AarnimM22/HD800-wireless/README.md

view online:
https://kicanvas.org/?repo=https%3A%2F%2Fgithub.com%2FAarnimM22%2FHD800-wireless
