AarnimM22/HD800-wireless/design/HD800-wireless-01 USB Charging.png

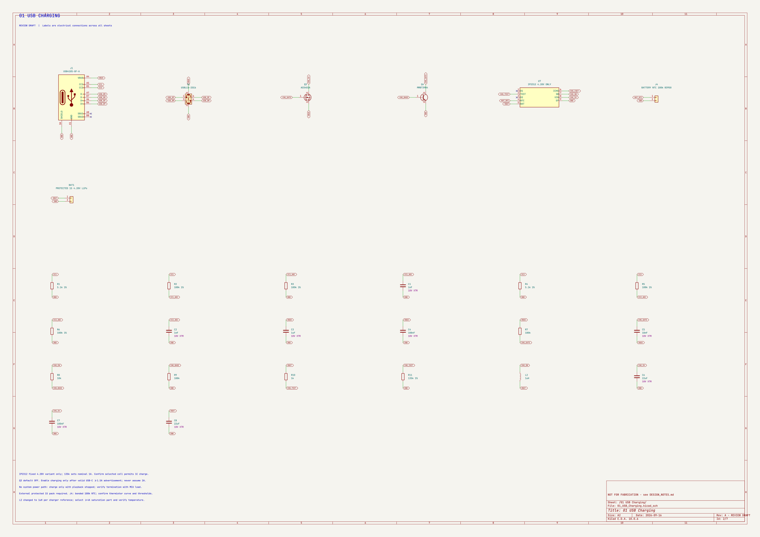
design/HD800-wireless-01 USB Charging.png
