AarnimM22/HD800-wireless/design/HD800-wireless-02 Power.png

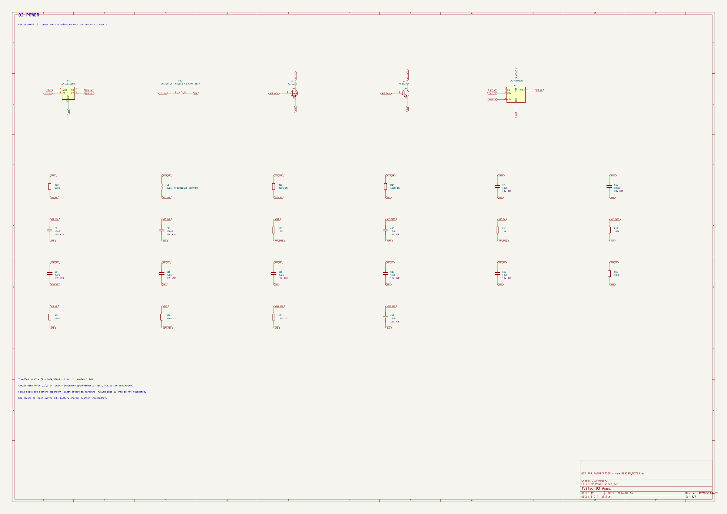
design/HD800-wireless-02 Power.png
