AarnimM22/HD800-wireless/design/HD800-wireless-03 MCU RF.png

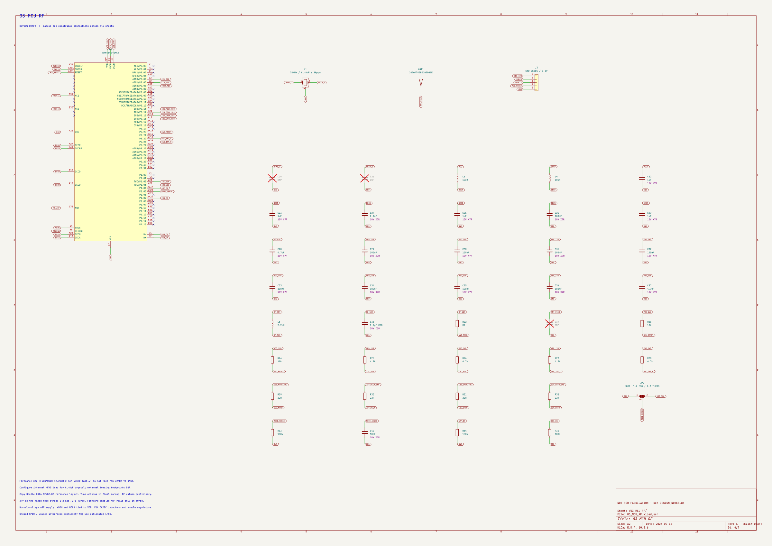
design/HD800-wireless-03 MCU RF.png
