AarnimM22/HD800-wireless/design/HD800-wireless-04 DAC Left.png

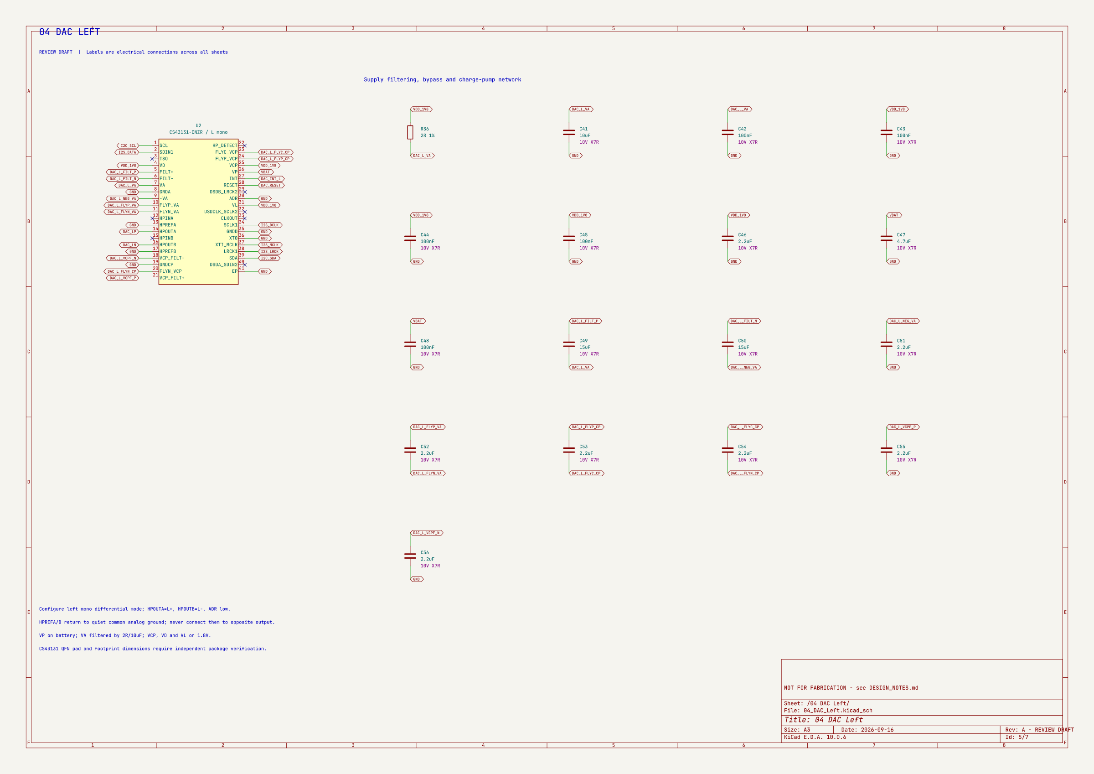
design/HD800-wireless-04 DAC Left.png
