AarnimM22/HD800-wireless/design/HD800-wireless-06 Balanced Output.png

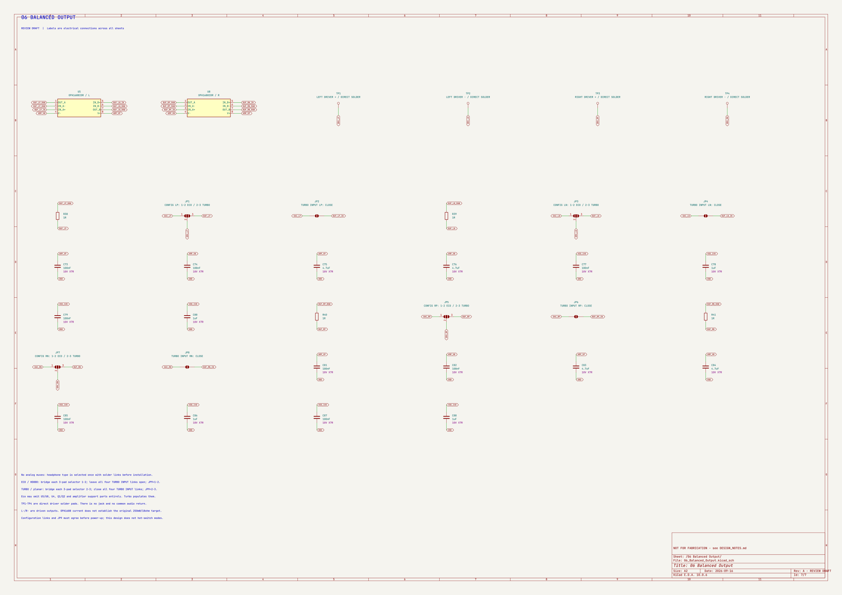
design/HD800-wireless-06 Balanced Output.png
