AarnimM22/HD800-wireless/design/HD800-wireless.png

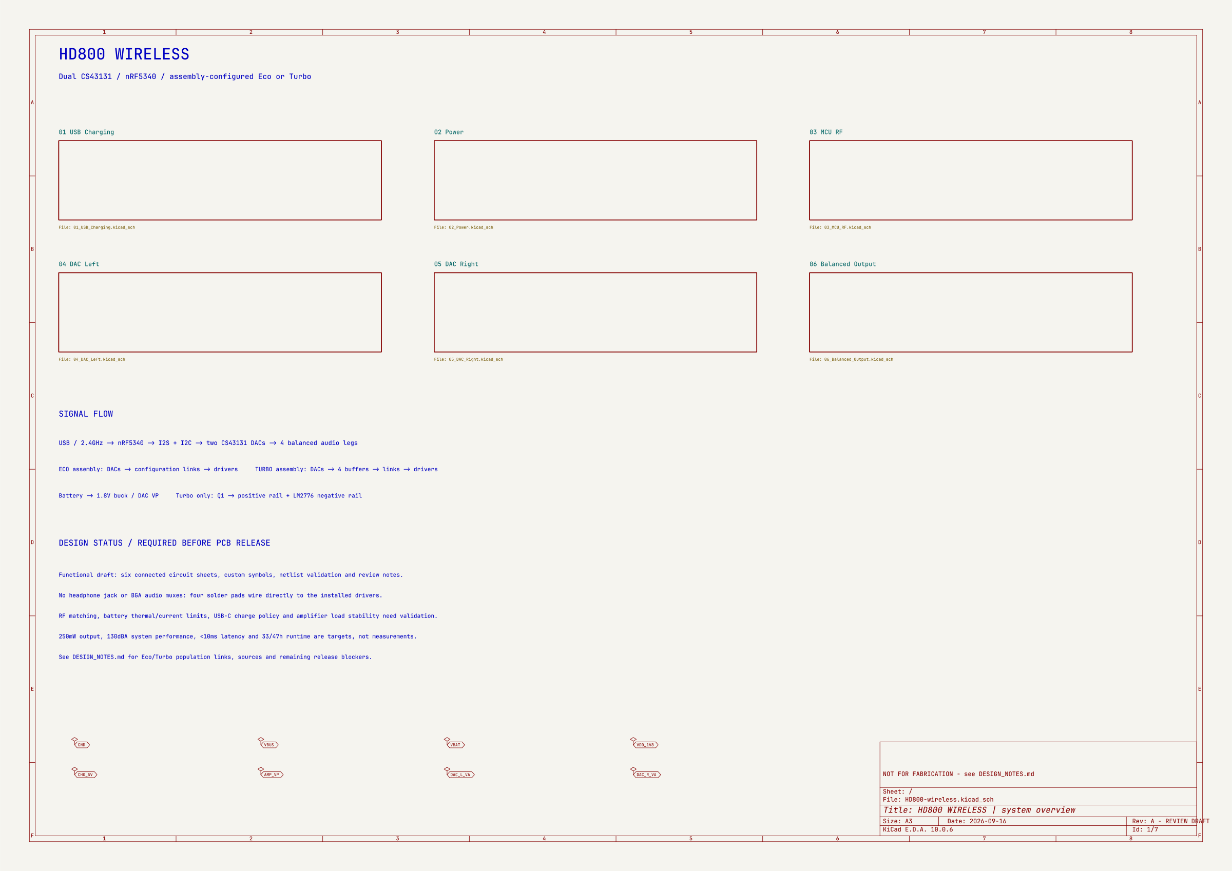
design/HD800-wireless.png
