AarnimM22/HD800-wireless/HD800-wireless.step

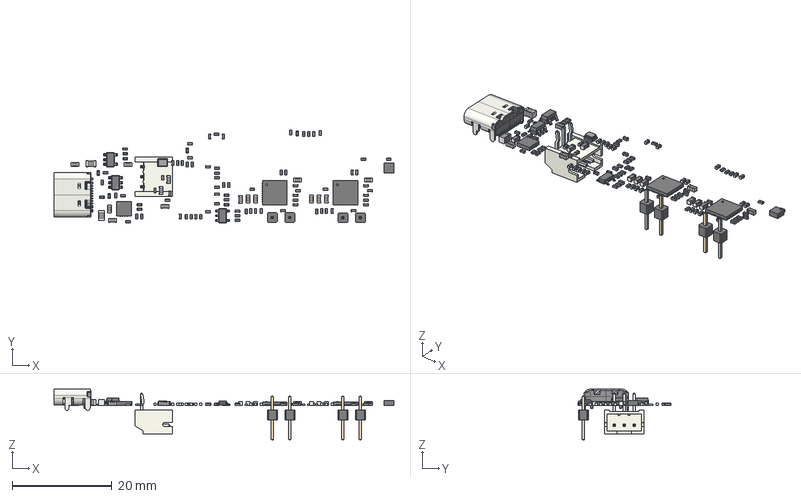
[picture p7: CAD file, 2026-09-24]
HD800-wireless.step
68.3 x 18.7 x 10.2 mm
R_0402_1005Metric x 31
C_0402_1005Metric x 53
USB_C_Receptacle_16P_TopMnt_Horizontal_GCT_USB4105-xx-A
L_0603_1608Metric x 2
C_0603_1608Metric x 13
L_0805_2012Metric x 2
SOT-23-5
Crystal_SMD_2016-4Pin_2.0x1.6mm
QFN-16-1EP_3x3mm_P0.5mm_EP1.7x1.7mm
TSOT-23-5
b3e03259-ada3-11ed-ad3b-6f420da3e38c_part x 2
b3e0325a-ada3-11ed-ad3b-6f420da3e38c_part x 2
b3e0325b-ada3-11ed-ad3b-6f420da3e38c_part x 2
L_0402_1005Metric
LGA_12_2x2mm_P05mm
SOT-23-6
PinHeader_1x01_P200mm_Vertical x 4
JST_S3B_PH_K
