AarnimM22/HD800-wireless/HD800-wireless.kicad_pcb

## KiCad design HD800-wireless.kicad_pcb (2026-09-24)

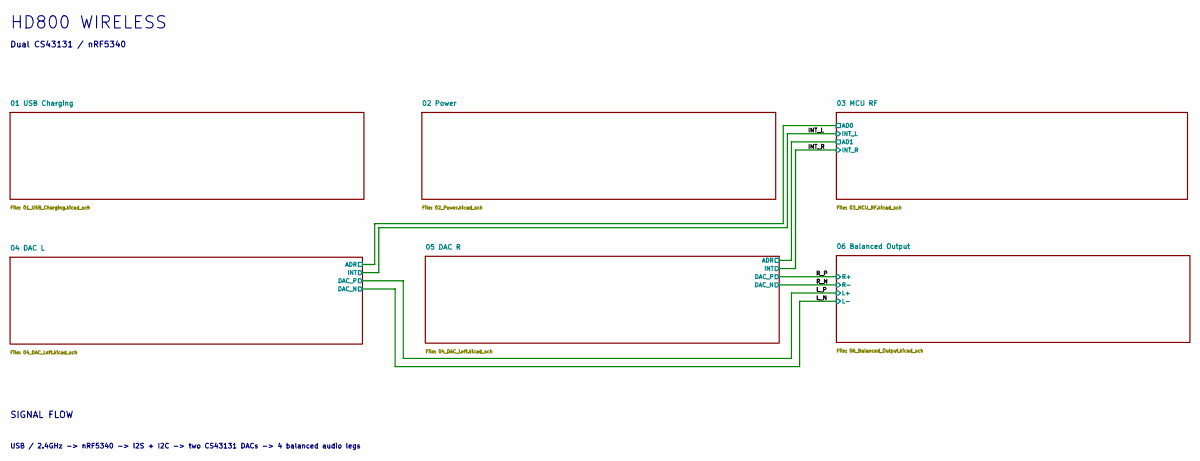
[picture p8: schematic HD800-wireless.kicad_sch, HD800 WIRELESS | system overview]

Notes on the sheet:
USB / 2.4GHz -> nRF5340 -> I2S + I2C -> two CS43131 DACs -> 4 balanced audio legs
Dual CS43131 / nRF5340
HD800 WIRELESS
SIGNAL FLOW

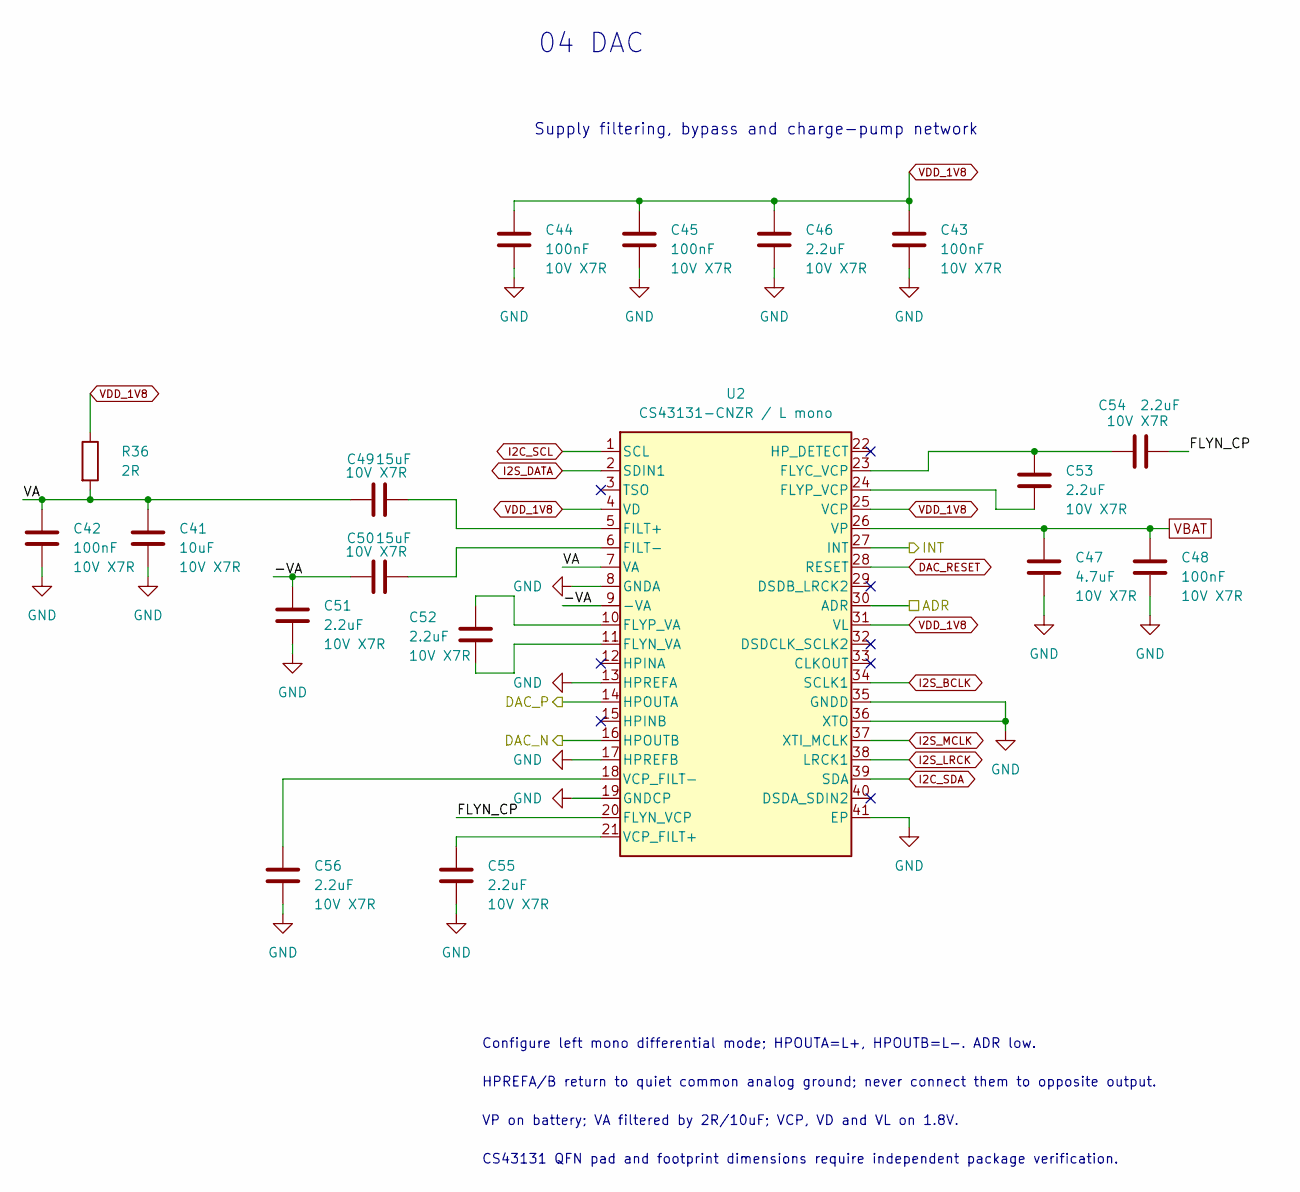
[picture p9: schematic 04_DAC_Left.kicad_sch, 04 DAC Left]

Parts:
C41: 10uF; C_0603_1608Metric; Voltage 10V X7R
C42, C43, C44, C45, C48: 100nF; C_0402_1005Metric; Voltage 10V X7R
C46, C51, C52, C53, C54, C55, C56: 2.2uF; C_0402_1005Metric; Voltage 10V X7R
C47: 4.7uF; C_0603_1608Metric; Voltage 10V X7R
C49, C50: 15uF; C_0603_1608Metric; Voltage 10V X7R
R36: 2R; R_0402_1005Metric
U2: CS43131-CNZR / L mono; TQFN-40-1EP_5x5mm_P0.4mm_EP3.5x3.5mm_ThermalVias

Connections:
/04 DAC L/-VA: C50.1, C51.1, U2.9 (-VA)
/04 DAC L/FLYN_CP: C54.2, U2.20 (FLYN_VCP)
/04 DAC L/VA: C41.1, C42.1, C49.1, R36.2, U2.7 (VA)
/INT_L: U2.27 (INT); also elsewhere on the board
/L_N: U2.16 (HPOUTB); also elsewhere on the board
/L_P: U2.14 (HPOUTA); also elsewhere on the board
DAC_RESET: U2.28 (RESET); also elsewhere on the board
GND: C41.2, C42.2, C43.2, C44.2, C45.2, C46.2, C47.2, C48.2, C51.2, C55.2, C56.2, U2.8 (GNDA), U2.13 (HPREFA), U2.17 (HPREFB), U2.19 (GNDCP), U2.30 (ADR), U2.35 (GNDD), U2.36 (XTO), U2.41 (EP); also elsewhere on the board
I2C_SCL: U2.1 (SCL); also elsewhere on the board
I2C_SDA: U2.39 (SDA); also elsewhere on the board
I2S_BCLK: U2.34 (SCLK1); also elsewhere on the board
I2S_DATA: U2.2 (SDIN1); also elsewhere on the board
I2S_LRCK: U2.38 (LRCK1); also elsewhere on the board
I2S_MCLK: U2.37 (XTI_MCLK); also elsewhere on the board
unnamed: C49.2, U2.5 (FILT+)
unnamed: C50.2, U2.6 (FILT-)
unnamed: C53.1, C54.1, U2.23 (FLYC_VCP)
unnamed: C52.2, U2.11 (FLYN_VA)
unnamed: C52.1, U2.10 (FLYP_VA)
unnamed: C53.2, U2.24 (FLYP_VCP)
unnamed: C55.1, U2.21 (VCP_FILT+)
unnamed: C56.1, U2.18 (VCP_FILT-)
VBAT: C47.1, C48.1, U2.26 (VP); also elsewhere on the board
VDD_1V8: C43.1, C44.1, C45.1, C46.1, R36.1, U2.4 (VD), U2.25 (VCP), U2.31 (VL); also elsewhere on the board

Parts of its further copies:
C57, C65, C66, C68, C72: 100nF; C_0402_1005Metric; Voltage 10V X7R
C58: 10uF; C_0603_1608Metric; Voltage 10V X7R
C59, C60, C63, C64, C67, C69, C71: 2.2uF; C_0402_1005Metric; Voltage 10V X7R
C61, C62: 15uF; C_0603_1608Metric; Voltage 10V X7R
C70: 4.7uF; C_0603_1608Metric; Voltage 10V X7R
R37: 2R; R_0402_1005Metric
U3: CS43131-CNZR / L mono; TQFN-40-1EP_5x5mm_P0.4mm_EP3.5x3.5mm_ThermalVias

Connections of its further copies:
/05 DAC R/-VA: C60.1, C62.1, U3.9 (-VA)
/05 DAC R/FLYN_CP: C71.2, U3.20 (FLYN_VCP)
/05 DAC R/VA: C57.1, C58.1, C61.1, R37.2, U3.7 (VA)
/INT_R: U3.27 (INT); also elsewhere on the board
/R_N: U3.16 (HPOUTB); also elsewhere on the board
/R_P: U3.14 (HPOUTA); also elsewhere on the board
DAC_RESET: U3.28 (RESET); also elsewhere on the board
GND: C57.2, C58.2, C59.2, C60.2, C63.2, C65.2, C66.2, C67.2, C68.2, C70.2, C72.2, U3.8 (GNDA), U3.13 (HPREFA), U3.17 (HPREFB), U3.19 (GNDCP), U3.35 (GNDD), U3.36 (XTO), U3.41 (EP); also elsewhere on the board
I2C_SCL: U3.1 (SCL); also elsewhere on the board
I2C_SDA: U3.39 (SDA); also elsewhere on the board
I2S_BCLK: U3.34 (SCLK1); also elsewhere on the board
I2S_DATA: U3.2 (SDIN1); also elsewhere on the board
I2S_LRCK: U3.38 (LRCK1); also elsewhere on the board
I2S_MCLK: U3.37 (XTI_MCLK); also elsewhere on the board
unnamed: C61.2, U3.5 (FILT+)
unnamed: C62.2, U3.6 (FILT-)
unnamed: C69.1, C71.1, U3.23 (FLYC_VCP)
unnamed: C64.2, U3.11 (FLYN_VA)
unnamed: C64.1, U3.10 (FLYP_VA)
unnamed: C69.2, U3.24 (FLYP_VCP)
unnamed: C63.1, U3.21 (VCP_FILT+)
unnamed: C59.1, U3.18 (VCP_FILT-)
VBAT: C70.1, C72.1, U3.26 (VP); also elsewhere on the board
VDD_1V8: C65.1, C66.1, C67.1, C68.1, R37.1, U3.4 (VD), U3.25 (VCP), U3.30 (ADR), U3.31 (VL); also elsewhere on the board

Notes on the sheet:
HPREFA/B return to quiet common analog ground; never connect them to opposite output.
Supply filtering, bypass and charge-pump network
Configure left mono differential mode; HPOUTA=L+, HPOUTB=L-. ADR low.
CS43131 QFN pad and footprint dimensions require independent package verification.
04 DAC
VP on battery; VA filtered by 2R/10uF; VCP, VD and VL on 1.8V.

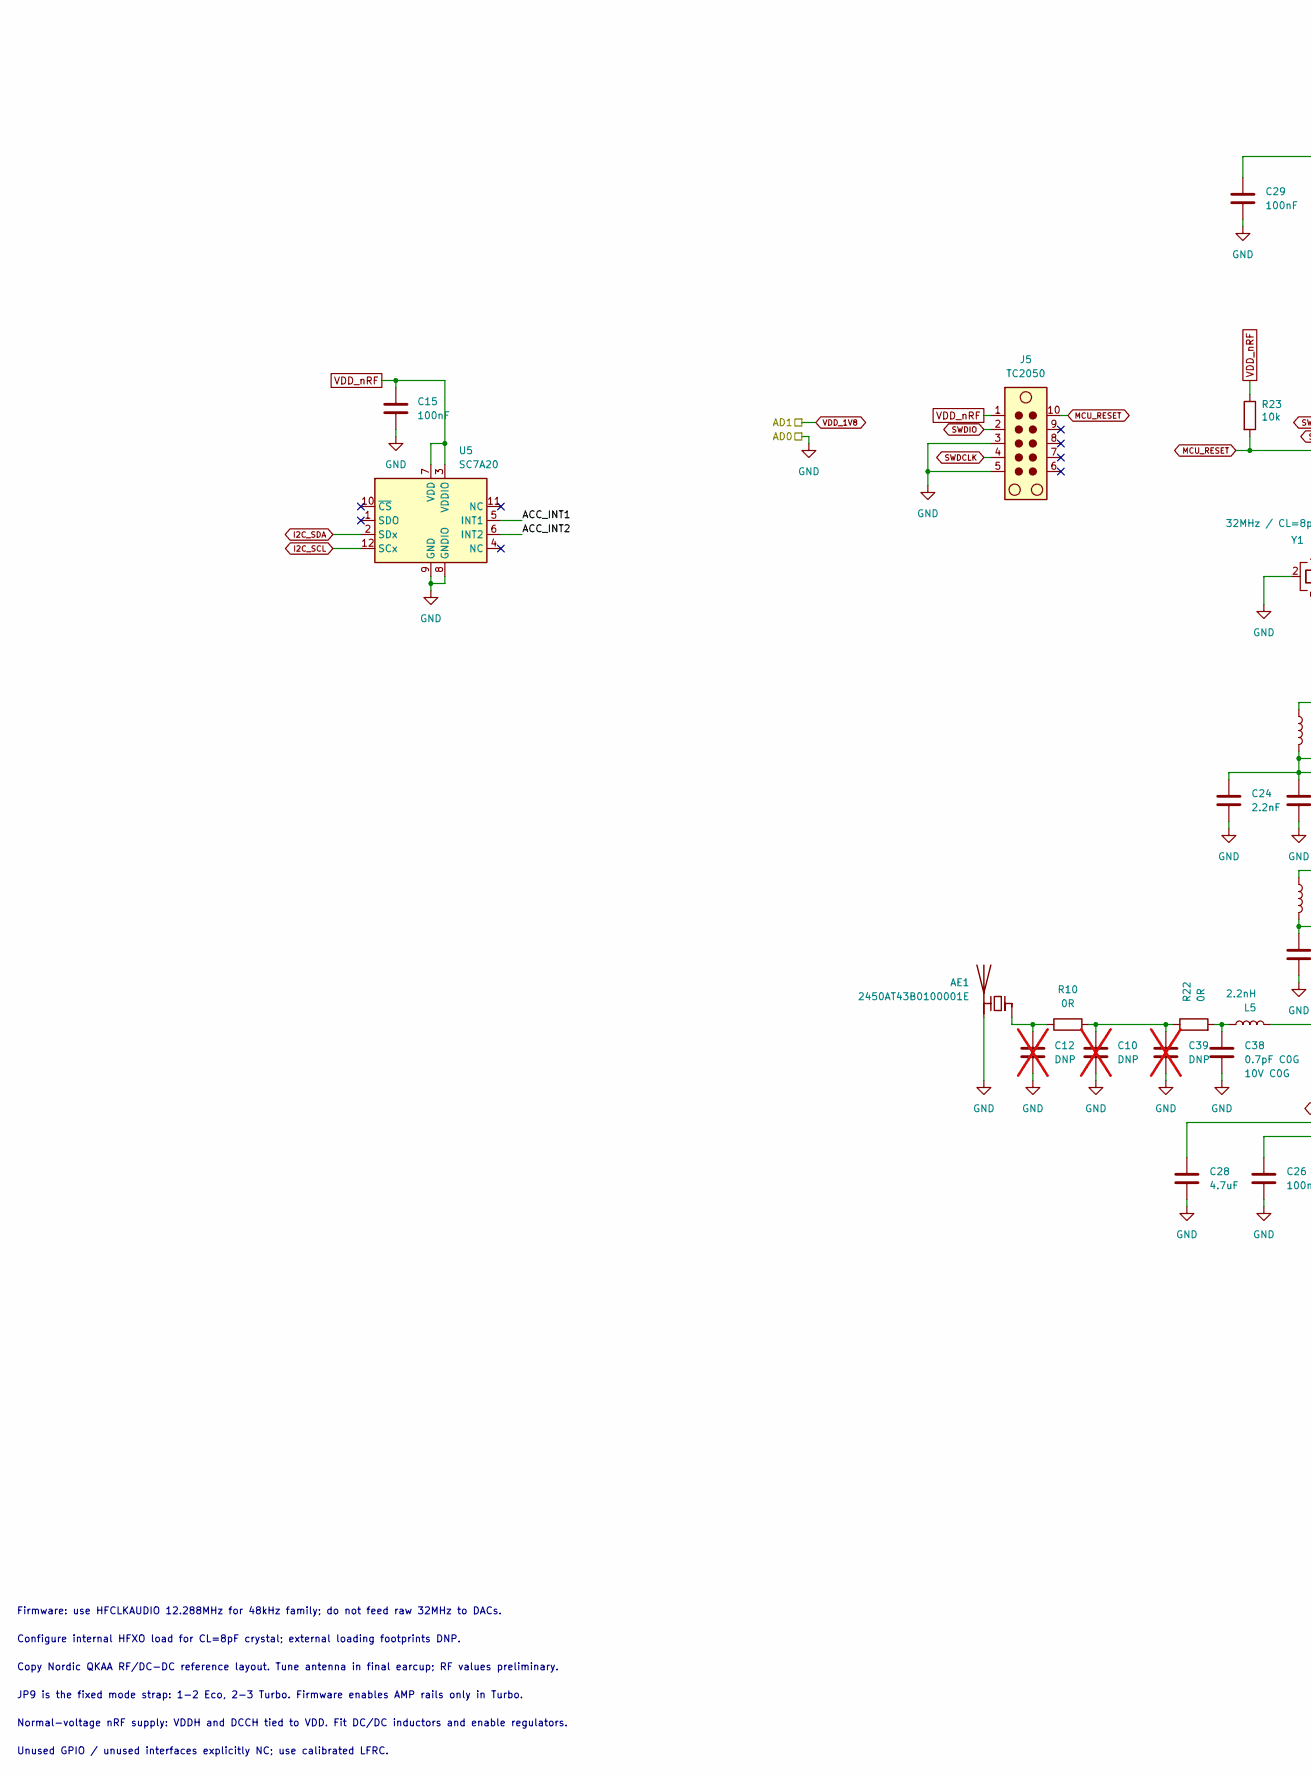
[picture p10: schematic 03_MCU_RF.kicad_sch, 03 MCU RF, part in row 1, column 1]

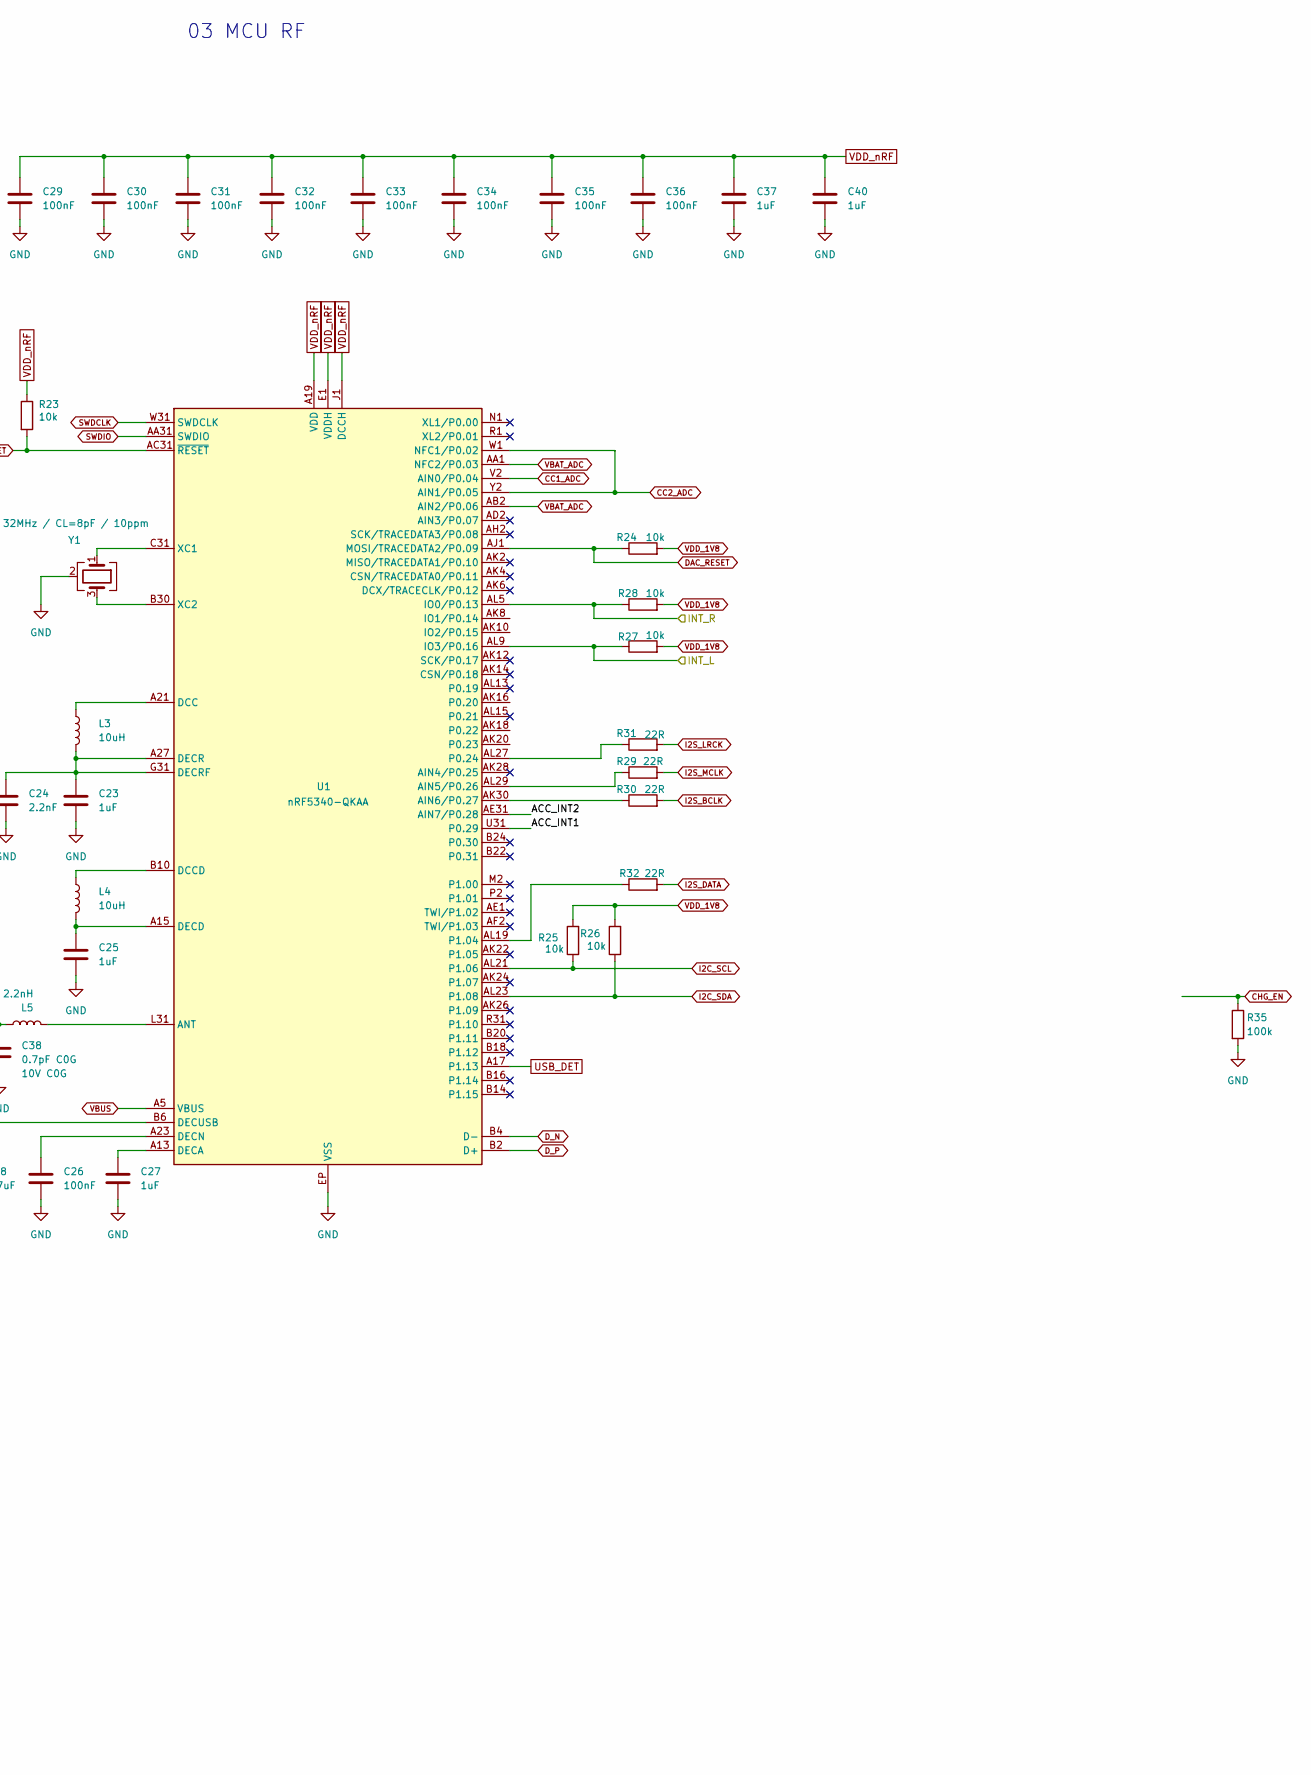
[picture p11: schematic 03_MCU_RF.kicad_sch, 03 MCU RF, part in row 1, column 2]

Parts:
AE1: 2450AT43B0100001E; 2450AT18D0100
C10, C12, C39: DNP; C_0402_1005Metric; not fitted
C15, C26, C29, C30, C31, C32, C33, C34, C35, C36: 100nF; C_0402_1005Metric
C23, C25, C27, C37, C40: 1uF; C_0402_1005Metric
C24: 2.2nF; C_0402_1005Metric
C28: 4.7uF; C_0603_1608Metric
C38: 0.7pF C0G; C_0402_1005Metric; Voltage 10V C0G
J5: TC2050; Tag-Connect_TC2050-IDC-FP_2x05_P1.27mm_Vertical
L3, L4: 10uH; L_0603_1608Metric
L5: 2.2nH; L_0402_1005Metric
R10, R22: 0R; R_0402_1005Metric
R23, R24, R25, R26, R27, R28: 10k; R_0402_1005Metric
R29, R30, R31, R32: 22R; R_0402_1005Metric
R35: 100k; R_0402_1005Metric
U1: nRF5340-QKAA; Nordic_AQFN-94-1EP_7x7mm_P0.4mm
U5: SC7A20; LGA-12_2x2mm_P0.5mm
Y1: 32MHz / CL=8pF / 10ppm; Crystal_SMD_2016-4Pin_2.0x1.6mm

Connections:
/03 MCU RF/ACC_INT1: U1.U31 (P0.29), U5.5 (INT1)
/03 MCU RF/ACC_INT2: U1.AE31 (AIN7/P0.28), U5.6 (INT2)
/INT_L: R27.1, U1.AL9 (IO3/P0.16); also elsewhere on the board
/INT_R: R28.1, U1.AL5 (IO0/P0.13); also elsewhere on the board
CC1_ADC: U1.V2 (AIN0/P0.04); also elsewhere on the board
CC2_ADC: U1.W1 (NFC1/P0.02), U1.Y2 (AIN1/P0.05); also elsewhere on the board
CHG_EN: R35.1; also elsewhere on the board
DAC_RESET: R24.1, U1.AJ1 (MOSI/TRACEDATA2/P0.09); also elsewhere on the board
D_N: U1.B4 (D-); also elsewhere on the board
D_P: U1.B2 (D+); also elsewhere on the board
GND: AE1.2 (PCB_Trace), C10.2, C12.2, C15.2, C23.2, C24.2, C25.2, C26.2, C27.2, C28.2, C29.2, C30.2, C31.2, C32.2, C33.2, C34.2, C35.2, C36.2, C37.2, C38.2, C39.2, C40.2, J5.3, J5.5, R35.2, U1.EP (VSS), U5.8 (GNDIO), U5.9 (GND), Y1.2 (G), Y1.4 (G); also elsewhere on the board
I2C_SCL: R25.1, U1.AL21 (P1.06), U5.12 (SCx); also elsewhere on the board
I2C_SDA: R26.1, U1.AL23 (P1.08), U5.2 (SDx); also elsewhere on the board
I2S_BCLK: R30.2; also elsewhere on the board
I2S_DATA: R32.2; also elsewhere on the board
I2S_LRCK: R31.2; also elsewhere on the board
I2S_MCLK: R29.2; also elsewhere on the board
MCU_RESET: J5.10, R23.2, U1.AC31 (~RESET)
unnamed: AE1.1 (FEED), C12.1, R10.1
unnamed: C10.1, C39.1, R10.2, R22.1
unnamed: C38.1, L5.1, R22.2
unnamed: R29.1, U1.AL29 (AIN5/P0.26)
unnamed: R30.1, U1.AK30 (AIN6/P0.27)
unnamed: L5.2, U1.L31 (ANT)
unnamed: L3.1, U1.A21 (DCC)
unnamed: L4.1, U1.B10 (DCCD)
unnamed: C27.1, U1.A13 (DECA)
unnamed: C25.1, L4.2, U1.A15 (DECD)
unnamed: C26.1, U1.A23 (DECN)
unnamed: C23.1, C24.1, L3.2, U1.A27 (DECR), U1.G31 (DECRF)
unnamed: C28.1, U1.B6 (DECUSB)
unnamed: R31.1, U1.AL27 (P0.24)
unnamed: R32.1, U1.AL19 (P1.04)
unnamed: U1.C31 (XC1), Y1.1
unnamed: U1.B30 (XC2), Y1.3
SWDCLK: J5.4, U1.W31 (SWDCLK)
SWDIO: J5.2, U1.AA31 (SWDIO)
USB_DET: U1.A17 (P1.13); also elsewhere on the board
VBAT_ADC: U1.AA1 (NFC2/P0.03), U1.AB2 (AIN2/P0.06); also elsewhere on the board
VBUS: U1.A5 (VBUS); also elsewhere on the board
VDD_1V8: R24.2, R25.2, R26.2, R27.2, R28.2; also elsewhere on the board
VDD_nRF: C15.1, C29.1, C30.1, C31.1, C32.1, C33.1, C34.1, C35.1, C36.1, C37.1, C40.1, J5.1, R23.1, U1.A19 (VDD), U1.AC1 (VDD), U1.AG1 (VDD), U1.AJ31 (VDD), U1.AL3 (VDD), U1.AL7 (VDD), U1.AL11 (VDD), U1.AL17 (VDD), U1.AL25 (VDD), U1.B8 (VDD), U1.B28 (VDD), U1.C1 (VDD), U1.E1 (VDDH), U1.E31 (VDD), U1.J1 (DCCH), U1.L1 (VDD), U1.N31 (VDD), U1.U1 (VDD), U5.3 (VDDIO), U5.7 (VDD); also elsewhere on the board

Notes on the sheet:
Normal-voltage nRF supply: VDDH and DCCH tied to VDD. Fit DC/DC inductors and enable regulators.
Configure internal HFXO load for CL=8pF crystal; external loading footprints DNP.
Copy Nordic QKAA RF/DC-DC reference layout. Tune antenna in final earcup; RF values preliminary.
Unused GPIO / unused interfaces explicitly NC; use calibrated LFRC.
03 MCU RF
JP9 is the fixed mode strap: 1-2 Eco, 2-3 Turbo. Firmware enables AMP rails only in Turbo.
Firmware: use HFCLKAUDIO 12.288MHz for 48kHz family; do not feed raw 32MHz to DACs.

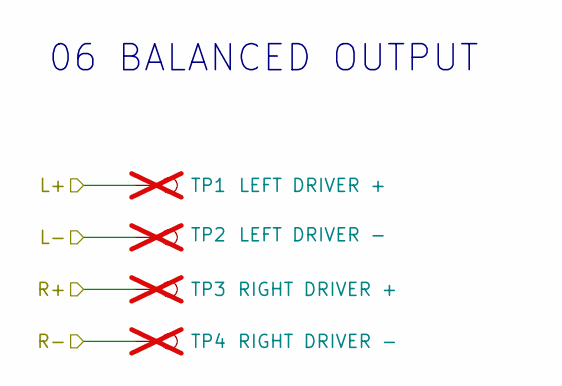
[picture p12: schematic 06_Balanced_Output.kicad_sch, 06 Balanced Output]

Parts:
TP1: LEFT DRIVER +; PinHeader_1x01_P2.00mm_Vertical; not fitted
TP2: LEFT DRIVER -; PinHeader_1x01_P2.00mm_Vertical; not fitted
TP3: RIGHT DRIVER +; PinHeader_1x01_P2.00mm_Vertical; not fitted
TP4: RIGHT DRIVER -; PinHeader_1x01_P2.00mm_Vertical; not fitted

Connections:
/L_N: TP2.1 (1_1); also elsewhere on the board
/L_P: TP1.1 (1_1); also elsewhere on the board
/R_N: TP4.1 (1_1); also elsewhere on the board
/R_P: TP3.1 (1_1); also elsewhere on the board

Notes on the sheet:
06 BALANCED OUTPUT

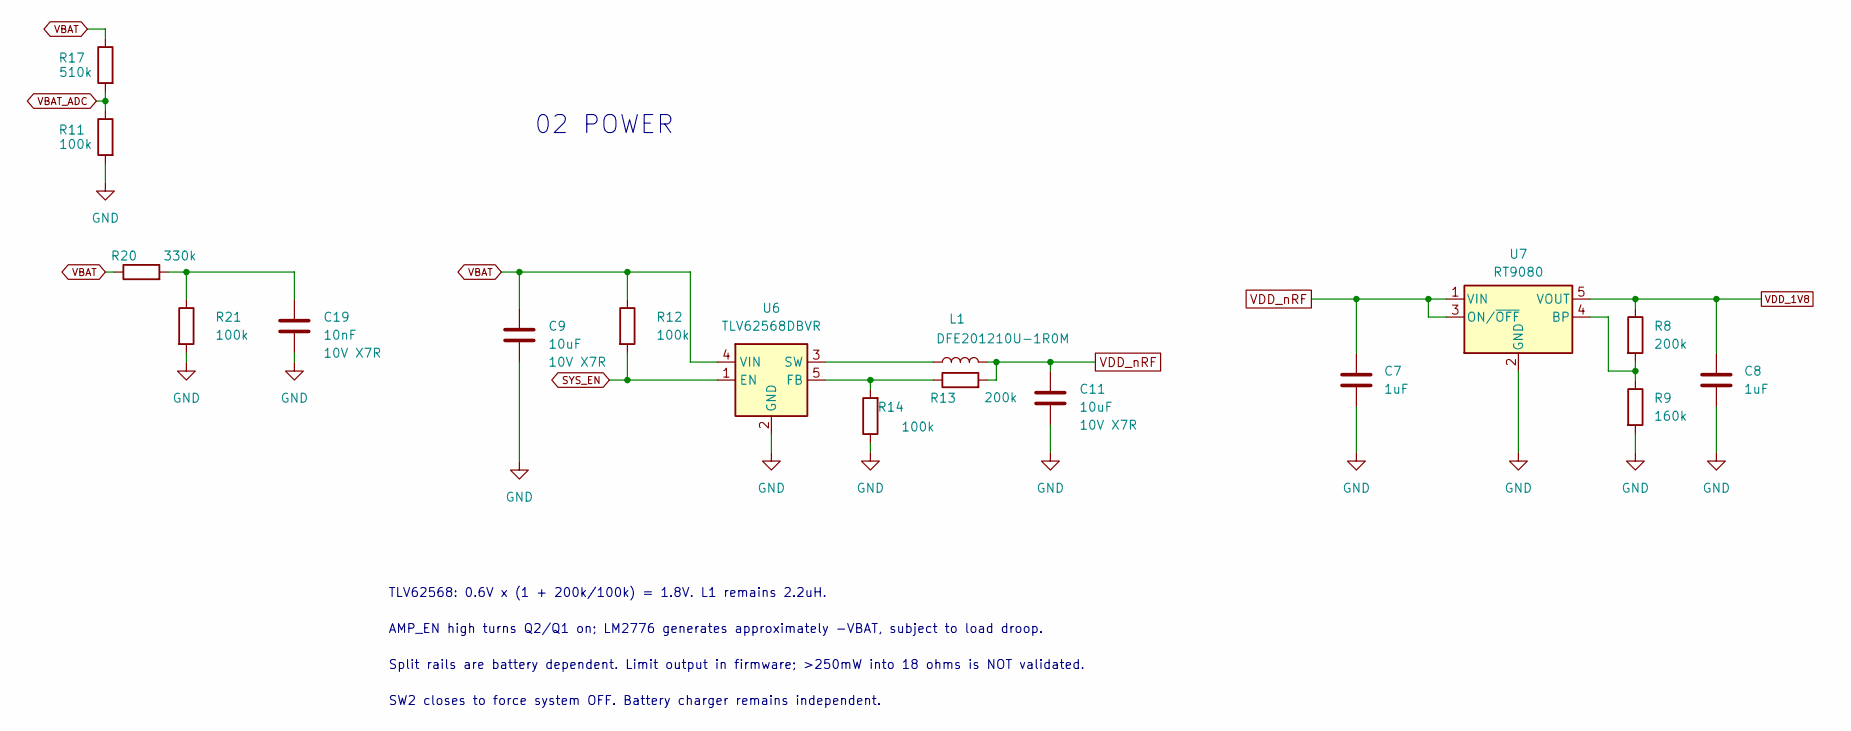
[picture p13: schematic 02_Power.kicad_sch, 02 Power]

Parts:
C7, C8: 1uF; C_0402_1005Metric
C9, C11: 10uF; C_0603_1608Metric; Voltage 10V X7R
C19: 10nF; C_0402_1005Metric; Voltage 10V X7R
L1: DFE201210U-1R0M; L_0805_2012Metric
R8, R13: 200k; R_0402_1005Metric
R9: 160k; R_0402_1005Metric
R11, R12, R14, R21: 100k; R_0402_1005Metric
R17: 510k; R_0402_1005Metric
R20: 330k; R_0402_1005Metric
U6: TLV62568DBVR; SOT-23-5
U7: RT9080; TSOT-23-5

Connections:
GND: C7.2, C8.2, C9.2, C11.2, C19.2, R9.2, R11.2, R14.1, R21.2, U6.2 (GND), U7.2 (GND); also elsewhere on the board
unnamed: C19.1, R20.2, R21.1
unnamed: R13.1, R14.2, U6.5 (FB)
unnamed: L1.1, U6.3 (SW)
unnamed: R8.2, R9.1, U7.4 (BP)
SYS_EN: R12.2, U6.1 (EN)
VBAT: C9.1, R12.1, R17.1, R20.1, U6.4 (VIN); also elsewhere on the board
VBAT_ADC: R11.1, R17.2; also elsewhere on the board
VDD_1V8: C8.1, R8.1, U7.5 (VOUT); also elsewhere on the board
VDD_nRF: C7.1, C11.1, L1.2, R13.2, U7.1 (VIN), U7.3 (ON/~OFF); also elsewhere on the board

Notes on the sheet:
02 POWER
AMP_EN high turns Q2/Q1 on; LM2776 generates approximately -VBAT, subject to load droop.
SW2 closes to force system OFF. Battery charger remains independent.
Split rails are battery dependent. Limit output in firmware; >250mW into 18 ohms is NOT validated.
TLV62568: 0.6V x (1 + 200k/100k) = 1.8V. L1 remains 2.2uH.

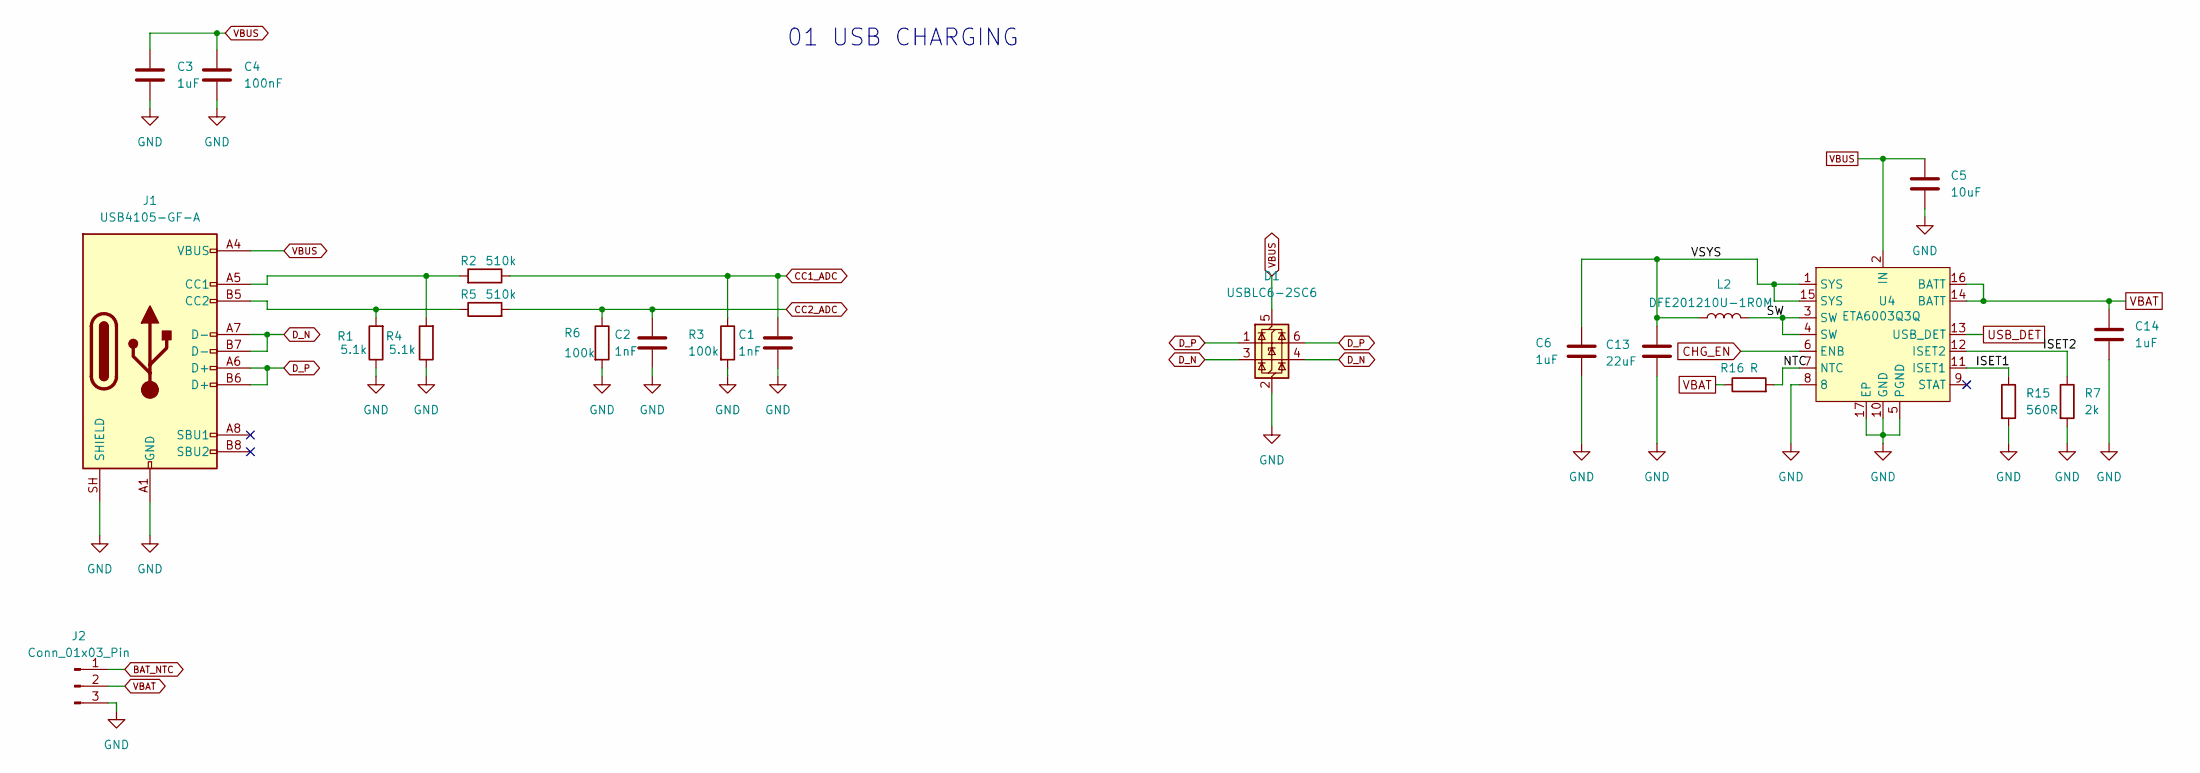
[picture p14: schematic 01_USB_Charging.kicad_sch, 01 USB Charging]

Parts:
C1, C2: 1nF; C_0402_1005Metric
C3, C6, C14: 1uF; C_0402_1005Metric
C4: 100nF; C_0402_1005Metric
C5: 10uF; C_0603_1608Metric
C13: 22uF; C_0603_1608Metric
D1: USBLC6-2SC6; SOT-23-6
J1: USB4105-GF-A; USB_C_Receptacle_GCT_USB4105-xx-A_16P_TopMnt_Horizontal
J2: Conn_01x03_Pin; JST_PH_S3B-PH-K_1x03_P2.00mm_Horizontal
L2: DFE201210U-1R0M; L_0805_2012Metric
R1, R4: 5.1k; R_0402_1005Metric
R2, R5: 510k; R_0402_1005Metric
R3, R6: 100k; R_0402_1005Metric
R7: 2k; R_0402_1005Metric
R15: 560R; R_0402_1005Metric
R16: R; R_0402_1005Metric
U4: ETA6003Q3Q; QFN-16-1EP_3x3mm_P0.5mm_EP1.7x1.7mm_ThermalVias

Connections:
/01 USB Charging/ISET1: R15.1, U4.11 (ISET1)
/01 USB Charging/ISET2: R7.1, U4.12 (ISET2)
/01 USB Charging/NTC: R16.2, U4.7 (NTC)
/01 USB Charging/SW: L2.2, U4.3 (SW), U4.4 (SW)
/01 USB Charging/VSYS: C6.1, C13.1, L2.1, U4.1 (SYS), U4.15 (SYS)
BAT_NTC: J2.1
CC1_ADC: C1.1, R2.1, R3.1; also elsewhere on the board
CC2_ADC: C2.1, R5.2, R6.1; also elsewhere on the board
CHG_EN: U4.6 (ENB); also elsewhere on the board
D_N: D1.3 (I/O2), D1.4 (I/O2), J1.A7 (D-), J1.B7 (D-); also elsewhere on the board
D_P: D1.1 (I/O1), D1.6 (I/O1), J1.A6 (D+), J1.B6 (D+); also elsewhere on the board
GND: C1.2, C2.2, C3.2, C4.2, C5.2, C6.2, C13.2, C14.1, D1.2 (GND), J1.A1 (GND), J1.A12 (GND), J1.B1 (GND), J1.B12 (GND), J1.SH (SHIELD), J2.3, R1.1, R3.2, R4.1, R6.2, R7.2, R15.2, U4.5 (PGND), U4.8, U4.10 (GND), U4.17 (EP); also elsewhere on the board
unnamed: J1.A5 (CC1), R2.2, R4.2
unnamed: J1.B5 (CC2), R1.2, R5.1
USB_DET: U4.13 (USB_DET); also elsewhere on the board
VBAT: C14.2, J2.2, R16.1, U4.14 (BATT), U4.16 (BATT); also elsewhere on the board
VBUS: C3.1, C4.1, C5.1, D1.5 (VBUS), J1.A4 (VBUS), J1.A9 (VBUS), J1.B4 (VBUS), J1.B9 (VBUS), U4.2 (IN); also elsewhere on the board

Notes on the sheet:
01 USB CHARGING

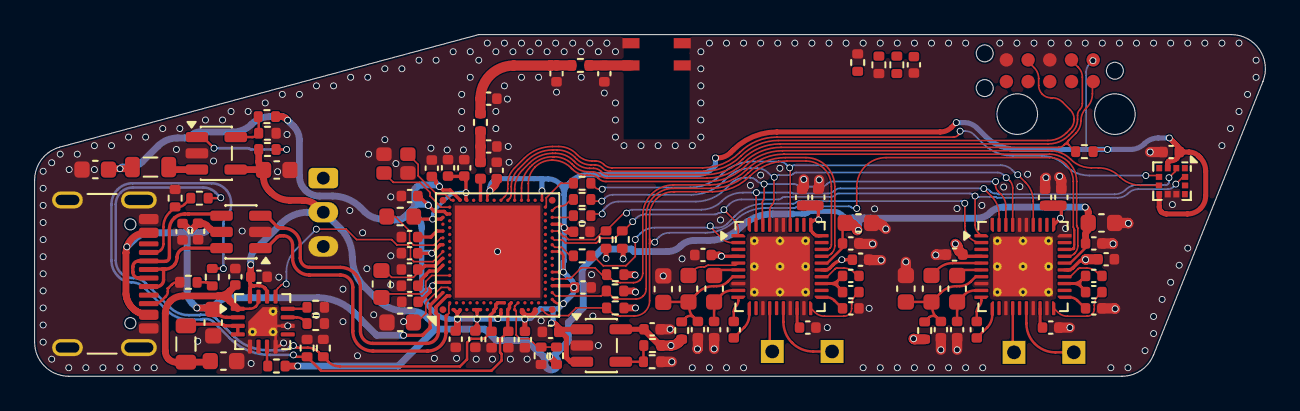
[picture p15: board HD800-wireless.kicad_pcb from above]

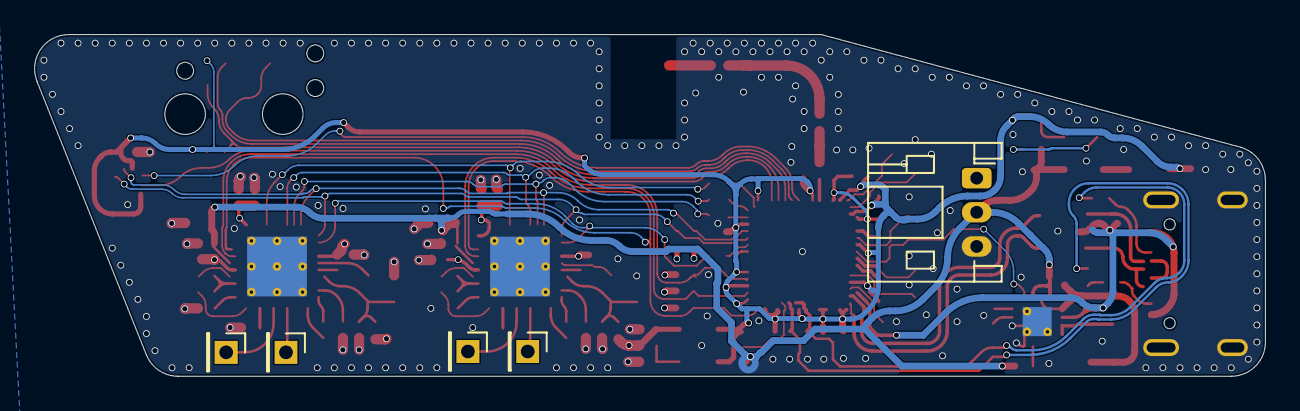
[picture p16: board HD800-wireless.kicad_pcb from below]

Board: 4 copper layers, 72.0 x 20.0 mm, 121 parts (5 on the bottom side), 81 nets.
