AarnimM22/HD800-wireless/(commit log)

2026-09-19 commit before dk firmware test
    [01_USB_Charging.kicad_sch, 02_Power.kicad_sch, 03_MCU_RF.kicad_sch, 04_DAC_Left.kicad_sch, 05_DAC_Right.kicad_sch, 06_Balanced_Output.kicad_sch, HD800-wireless.kicad_pcb, HD800-wireless.kicad_sch]
2026-09-24 removed firmware
    [01_USB_Charging.kicad_sch, 02_Power.kicad_sch, 03_MCU_RF.kicad_sch, 04_DAC_Left.kicad_sch, 06_Balanced_Output.kicad_sch, HD800-wireless.kicad_pcb, HD800-wireless.kicad_sch, HD800-wireless.step]
